MiguelCama/AVR-VemaQ-Controller/PCB_Layout.png

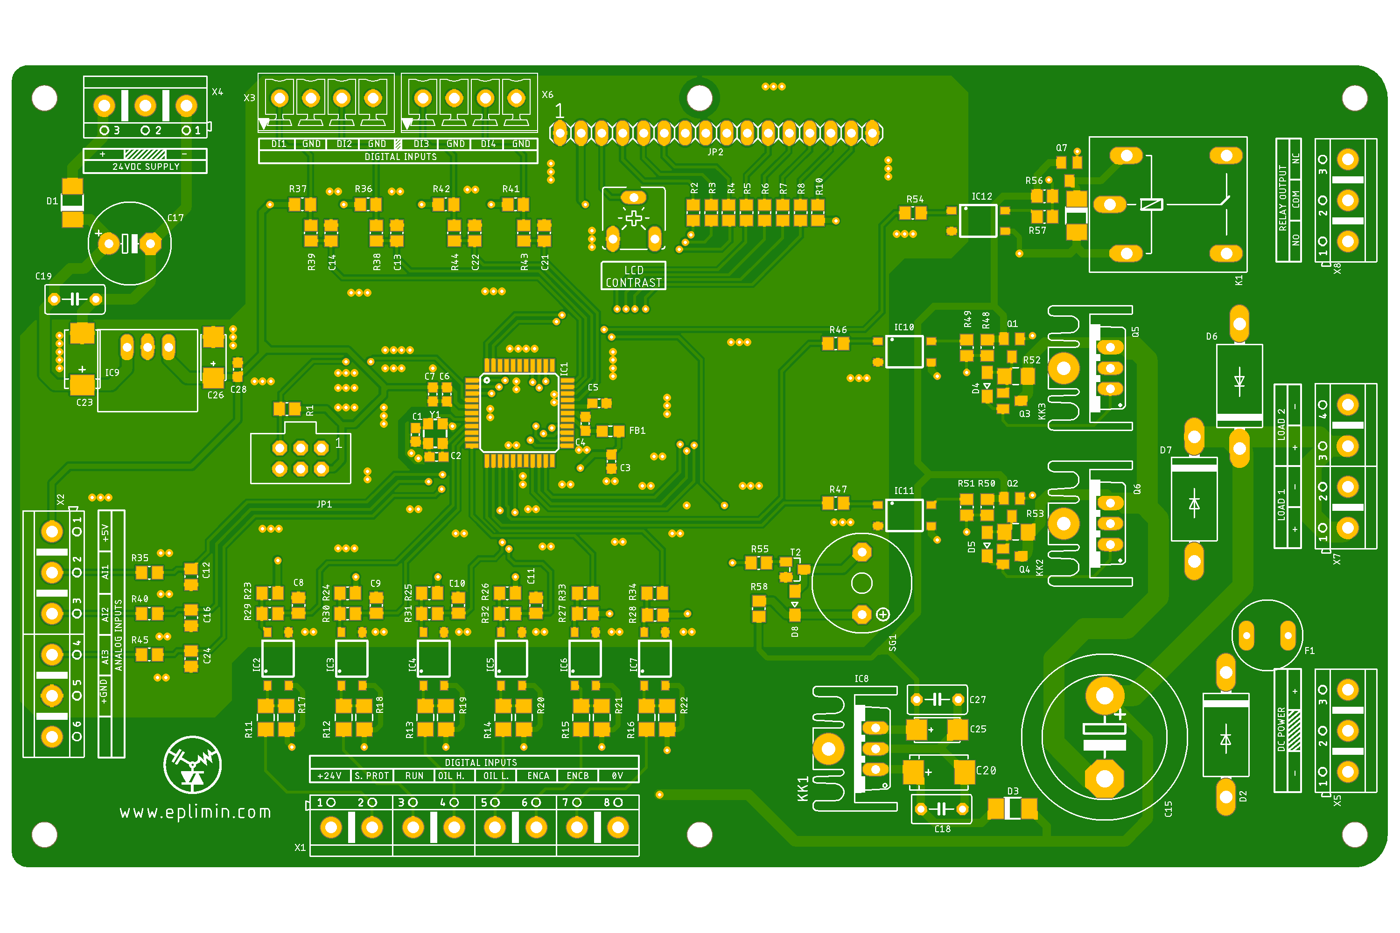
PCB_Layout.png
