MiguelCama/AVR-VemaQ-Controller/Requirements.png

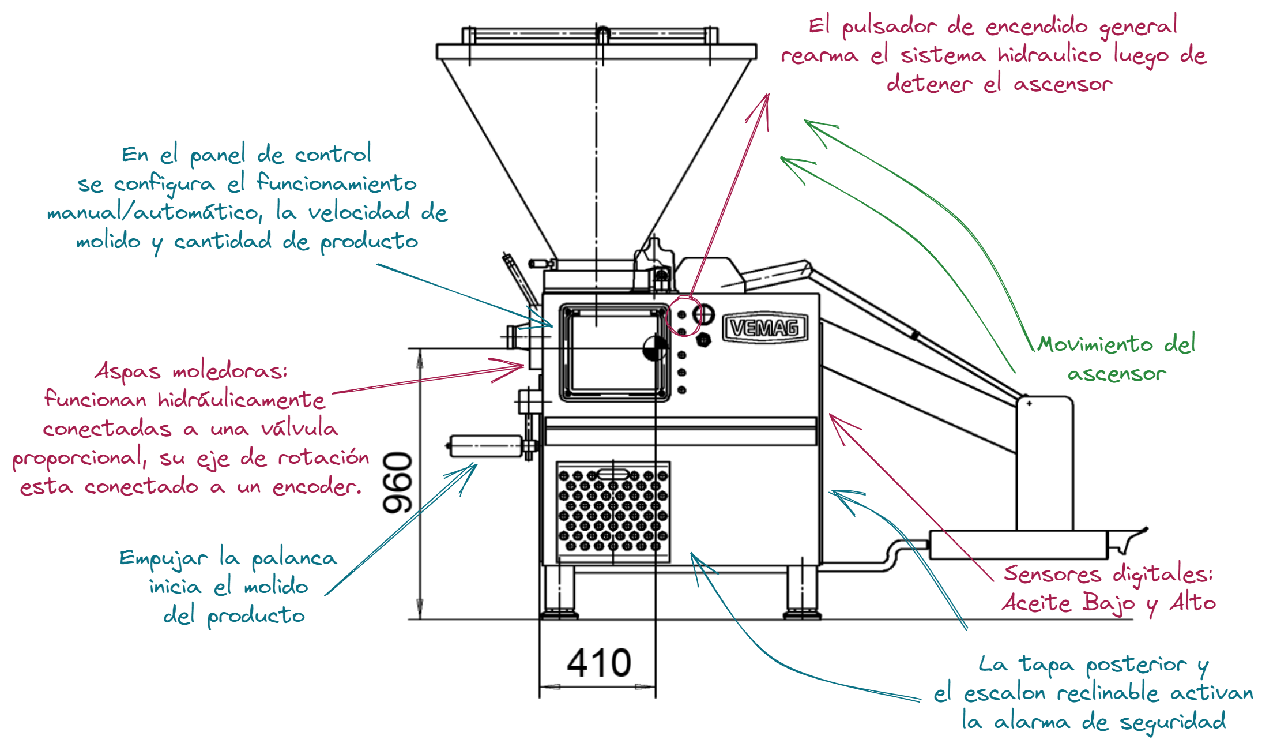
Requirements.png
