MiguelCama/AVR-VemaQ-Controller/FSM_UML.pdf

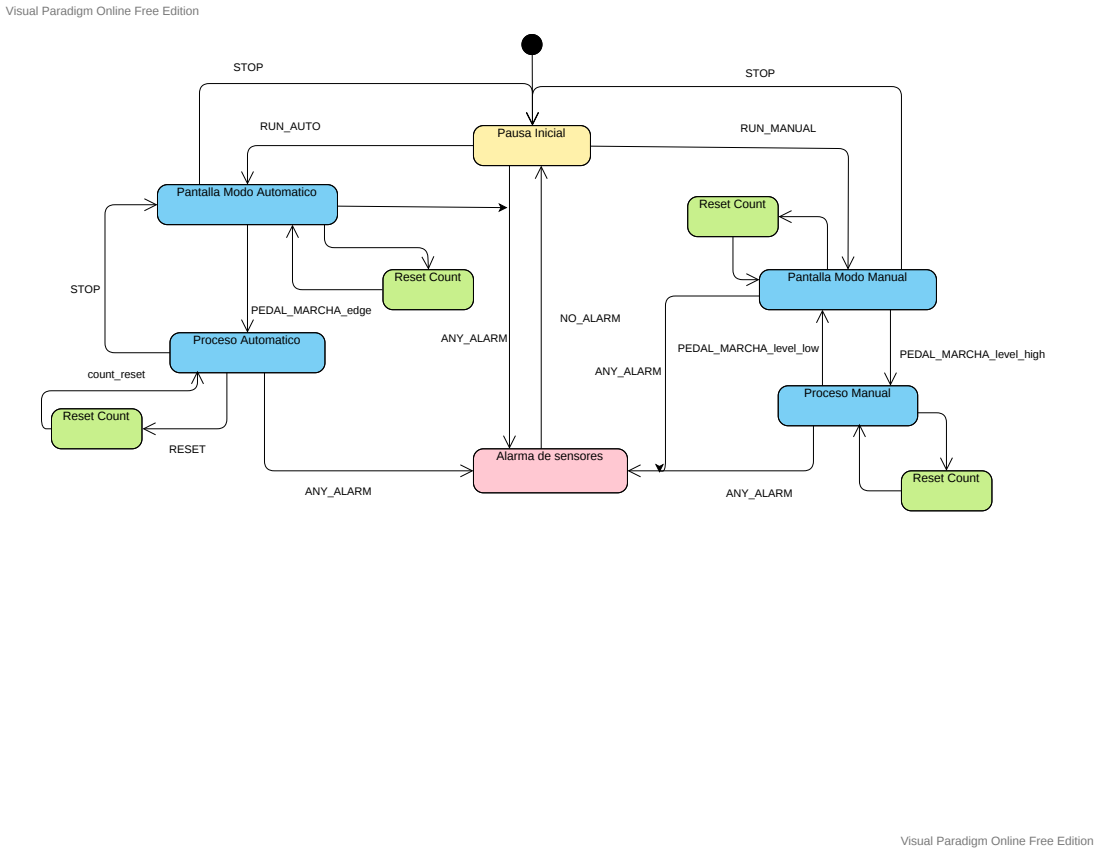
[picture p3: page 1]
Pausa Inicial; ANY_ALARM; RUN_MANUAL; RUN_AUTO; Proceso Automatico; Proceso Manual; PEDAL_MARCHA_edge; PEDAL_MARCHA_level_high; NO_ALARM; STOP; Reset Count; RESET; count_reset; PEDAL_MARCHA_level_low

Visual Paradigm Online Free Edition

Pantalla Modo Automatico

Pantalla Modo Manual

Alarma de sensores
