MiguelCama/AVR-VemaQ-Controller/Schematic/vemag_CPU_v2_2.brd

## EAGLE design Schematic/vemag_CPU_v2_2.brd (2024-03-04)

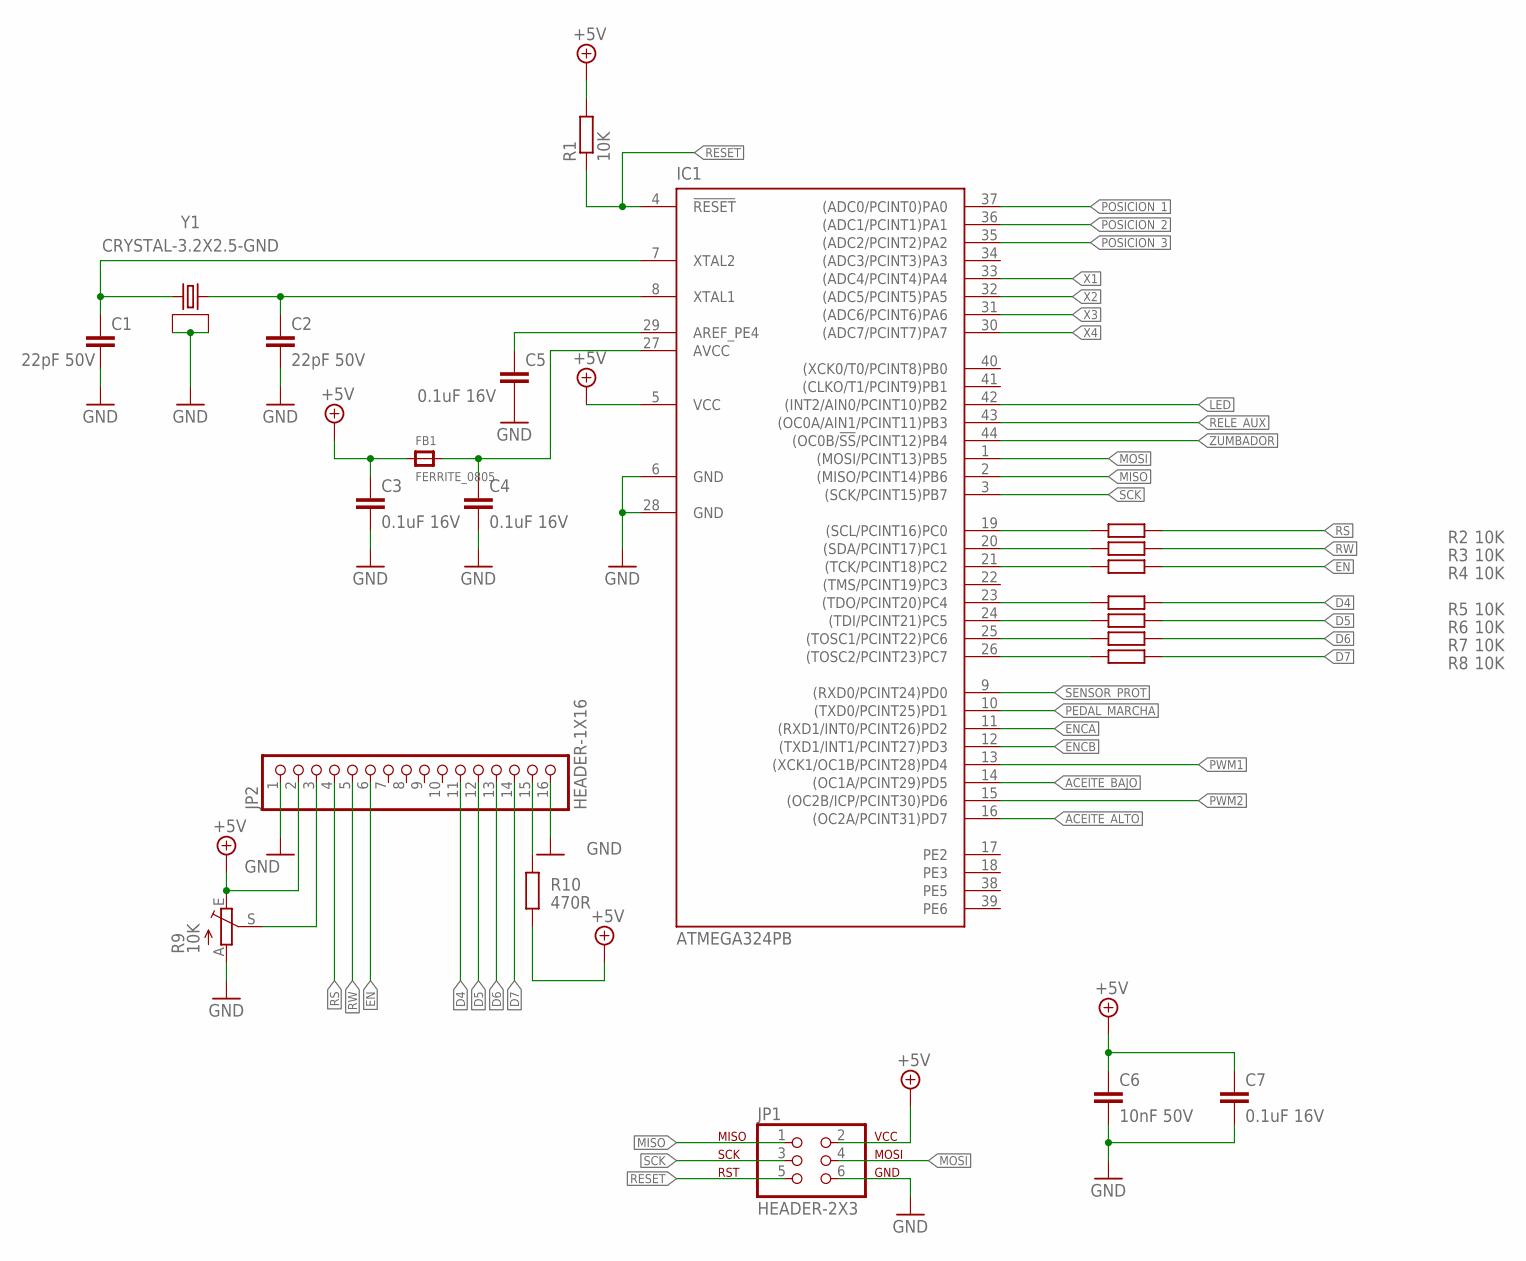
[picture p4: schematic vemag_CPU_v2_2.sch, sheet 1, Microcontroller]

Parts:
C1, C2: 22pF 50V; C0603
C3, C4, C5, C7: 0.1uF 16V; C0603
C6: 10nF 50V; C0603
FB1: FERRITE_0805; _0805
IC1: ATMEGA324PB; TQFP44
JP1: HEADER-2X3; ISP_AVR_6P
JP2: HEADER-1X16; 1X16
R1, R2, R3, R4, R5, R6, R7, R8: 10K; R0805
R9: 10K; CA6V
R10: 470R; R0805
Y1: CRYSTAL-3.2X2.5-GND; CRYSTAL-SMD-3.2X2.5MM

Connections:
+5V: C3.1, C6.1, C7.1, FB1.1, IC1.5 (VCC), JP1.2, JP2.2, R1.2, R9.E, R10.1; also elsewhere on the board
ACEITE_ALTO: IC1.16 ((OC2A/PCINT31)PD7); also elsewhere on the board
ACEITE_BAJO: IC1.14 ((OC1A/PCINT29)PD5); also elsewhere on the board
D4: JP2.11, R5.1
D5: JP2.12, R6.1
D6: JP2.13, R7.1
D7: JP2.14, R8.1
EN: JP2.6, R4.1
ENCA: IC1.11 ((RXD1/INT0/PCINT26)PD2); also elsewhere on the board
ENCB: IC1.12 ((TXD1/INT1/PCINT27)PD3); also elsewhere on the board
GND: C1.2, C2.2, C3.2, C4.2, C5.2, C6.2, C7.2, IC1.6 (GND), IC1.28 (GND), JP1.6, JP2.1, JP2.16, R9.A, Y1.2 (GND), Y1.4 (GND); also elsewhere on the board
LED: IC1.42 ((INT2/AIN0/PCINT10)PB2)
MISO: IC1.2 ((MISO/PCINT14)PB6), JP1.1
MOSI: IC1.1 ((MOSI/PCINT13)PB5), JP1.4
unnamed: C1.1, IC1.7 (XTAL2), Y1.1 (2)
unnamed: C2.1, IC1.8 (XTAL1), Y1.3 (1)
unnamed: C5.1, IC1.29 (AREF_PE4)
unnamed: JP2.3, R9.S
unnamed: C4.1, FB1.2, IC1.27 (AVCC)
unnamed: IC1.26 ((TOSC2/PCINT23)PC7), R8.2
unnamed: IC1.25 ((TOSC1/PCINT22)PC6), R7.2
unnamed: IC1.24 ((TDI/PCINT21)PC5), R6.2
unnamed: IC1.23 ((TDO/PCINT20)PC4), R5.2
unnamed: IC1.21 ((TCK/PCINT18)PC2), R4.2
unnamed: IC1.20 ((SDA/PCINT17)PC1), R3.2
unnamed: IC1.19 ((SCL/PCINT16)PC0), R2.2
unnamed: JP2.15, R10.2
PE2: IC1.17 (PE2)
PE3: IC1.18 (PE3)
PE5: IC1.38 (PE5)
PE6: IC1.39 (PE6)
PEDAL_MARCHA: IC1.10 ((TXD0/PCINT25)PD1); also elsewhere on the board
POSICION_1: IC1.37 ((ADC0/PCINT0)PA0); also elsewhere on the board
POSICION_2: IC1.36 ((ADC1/PCINT1)PA1); also elsewhere on the board
POSICION_3: IC1.35 ((ADC2/PCINT2)PA2); also elsewhere on the board
PWM1: IC1.13 ((XCK1/OC1B/PCINT28)PD4); also elsewhere on the board
PWM2: IC1.15 ((OC2B/ICP/PCINT30)PD6); also elsewhere on the board
RELE_AUX: IC1.43 ((OC0A/AIN1/PCINT11)PB3); also elsewhere on the board
RESET: IC1.4 (!RESET), JP1.5, R1.1
RS: JP2.4, R2.1
RW: JP2.5, R3.1
SCK: IC1.3 ((SCK/PCINT15)PB7), JP1.3
SENSOR_PROT: IC1.9 ((RXD0/PCINT24)PD0); also elsewhere on the board
X1: IC1.33 ((ADC4/PCINT4)PA4); also elsewhere on the board
X2: IC1.32 ((ADC5/PCINT5)PA5); also elsewhere on the board
X3: IC1.31 ((ADC6/PCINT6)PA6); also elsewhere on the board
X4: IC1.30 ((ADC7/PCINT7)PA7); also elsewhere on the board
ZUMBADOR: IC1.44 ((OC0B/!SS!/PCINT12)PB4); also elsewhere on the board

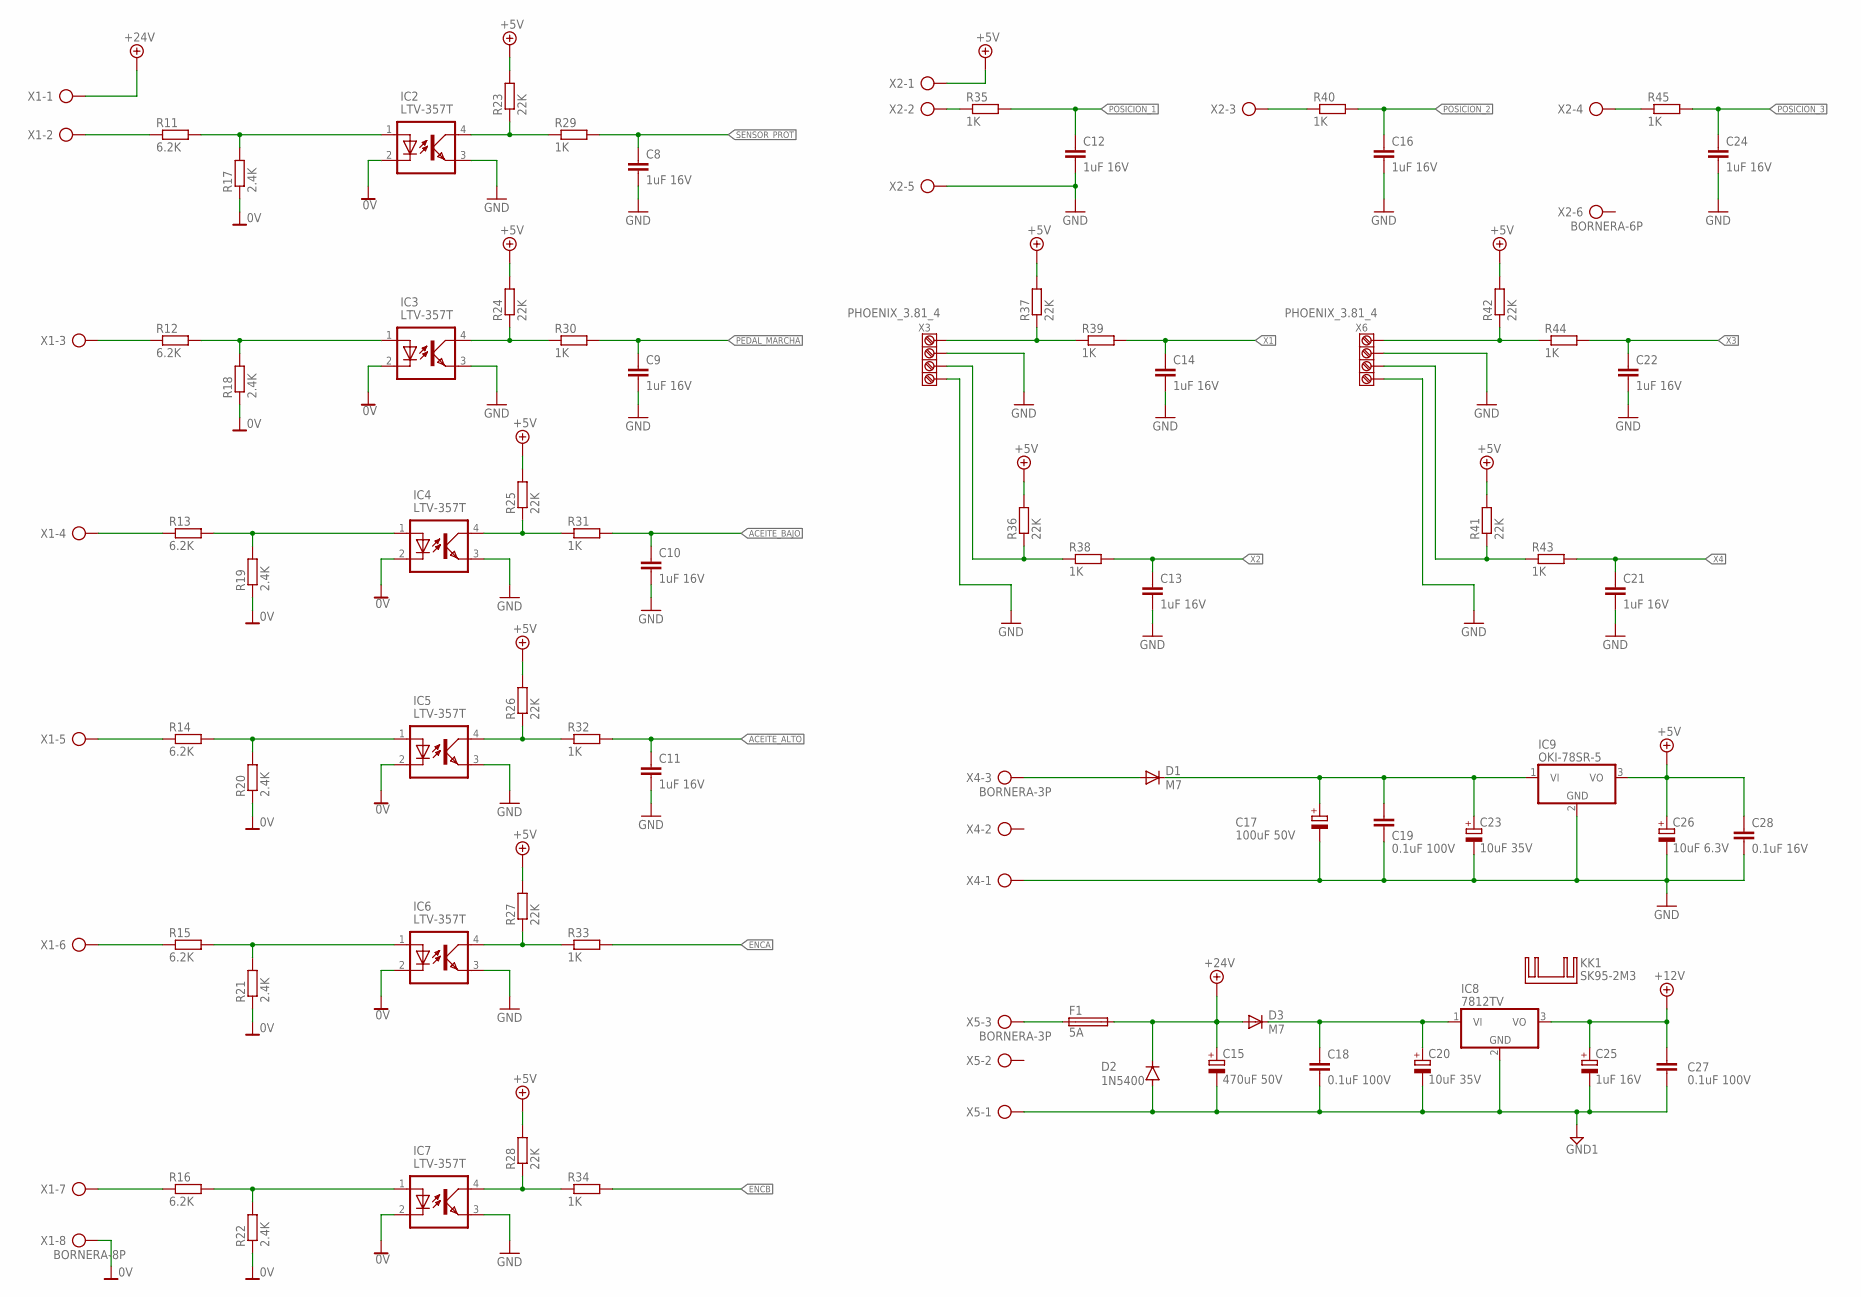
[picture p5: schematic vemag_CPU_v2_2.sch, sheet 2, Inputs / Power Supply]

Parts:
C8, C9, C10, C11, C12, C13, C14, C16, C21, C22, C24: 1uF 16V; C0805
C15: 470uF 50V; EB20D
C17: 100uF 50V; E5-10,5
C18, C19, C27: 0.1uF 100V; C050-035X075
C20, C23: 10uF 35V; SMC_D
C25: 1uF 16V; SMC_C
C26: 10uF 6.3V; SMC_C
C28: 0.1uF 16V; C0603
D1, D3: M7; DIODE_DO-214AC
D2: 1N5400; DO201-15
F1: 5A; TR5
IC2, IC3, IC4, IC5, IC6, IC7: LTV-357T
IC8: 7812TV; TO220V
IC9: OKI-78SR-5; TO220V-OKI-ISO
KK1: SK95-2M3
R11, R12, R13, R14, R15, R16: 6.2K; R1206
R17, R18, R19, R20, R21, R22: 2.4K; R1206
R23, R24, R25, R26, R27, R28, R36, R37, R41, R42: 22K; R0805
R29, R30, R31, R32, R33, R34, R35, R38, R39, R40, R43, R44, R45: 1K; R0805
X1: BORNERA-8P; AK500/8
X2: BORNERA-6P; AK500/6
X3, X6: PHOENIX_3.81_4; 3.81-4
X4, X5: BORNERA-3P; AK500/3

Connections:
0V: IC2.2 (CATHODE), IC3.2 (CATHODE), IC4.2 (CATHODE), IC5.2 (CATHODE), IC6.2 (CATHODE), IC7.2 (CATHODE), R17.1, R18.1, R19.1, R20.1, R21.1, R22.1, X1.8
+5V: C26.+, C28.1, IC9.3 (VO), R23.2, R24.2, R25.2, R26.2, R27.2, R28.2, R36.2, R37.2, R41.2, R42.2, X2.1; also elsewhere on the board
+12V: C25.+, C27.1, IC8.3 (VO); also elsewhere on the board
+24V: C15.+, D2.C, D3.A, F1.2, X1.1; also elsewhere on the board
ACEITE_ALTO: C11.1, R32.2; also elsewhere on the board
ACEITE_BAJO: C10.1, R31.2; also elsewhere on the board
ENCA: R33.2; also elsewhere on the board
ENCB: R34.2; also elsewhere on the board
GND: C8.2, C9.2, C10.2, C11.2, C12.2, C13.2, C14.2, C16.2, C17.-, C19.2, C21.2, C22.2, C23.-, C24.2, C26.-, C28.2, IC2.3 (EM), IC3.3 (EM), IC4.3 (EM), IC5.3 (EM), IC6.3 (EM), IC7.3 (EM), IC9.2 (GND), X2.5, X3.2, X3.4, X4.1, X6.2, X6.4; also elsewhere on the board
GND1: C15.-, C18.2, C20.-, C25.-, C27.2, D2.A, IC8.2 (GND), X5.1; also elsewhere on the board
unnamed: D1.A, X4.3
unnamed: IC2.1 (ANODE), R11.2, R17.2
unnamed: IC2.4 (COL), R23.1, R29.1
unnamed: R35.1, X2.2
unnamed: IC3.1 (ANODE), R12.2, R18.2
unnamed: C18.1, C20.+, D3.C, IC8.1 (VI)
unnamed: IC3.4 (COL), R24.1, R30.1
unnamed: IC4.1 (ANODE), R13.2, R19.2
unnamed: IC4.4 (COL), R25.1, R31.1
unnamed: IC5.1 (ANODE), R14.2, R20.2
unnamed: IC5.4 (COL), R26.1, R32.1
unnamed: IC6.1 (ANODE), R15.2, R21.2
unnamed: IC6.4 (COL), R27.1, R33.1
unnamed: IC7.1 (ANODE), R16.2, R22.2
unnamed: IC7.4 (COL), R28.1, R34.1
unnamed: R16.1, X1.7
unnamed: R15.1, X1.6
unnamed: R14.1, X1.5
unnamed: R13.1, X1.4
unnamed: R12.1, X1.3
unnamed: R11.1, X1.2
unnamed: F1.1, X5.3
unnamed: C17.+, C19.1, C23.+, D1.C, IC9.1 (VI)
unnamed: R40.1, X2.3
unnamed: R45.1, X2.4
unnamed: R37.1, R39.1, X3.1
unnamed: R36.1, R38.1, X3.3
unnamed: R42.1, R44.1, X6.1
unnamed: R41.1, R43.1, X6.3
PEDAL_MARCHA: C9.1, R30.2; also elsewhere on the board
POSICION_1: C12.1, R35.2; also elsewhere on the board
POSICION_2: C16.1, R40.2; also elsewhere on the board
POSICION_3: C24.1, R45.2; also elsewhere on the board
SENSOR_PROT: C8.1, R29.2; also elsewhere on the board
X1: C14.1, R39.2; also elsewhere on the board
X2: C13.1, R38.2; also elsewhere on the board
X3: C22.1, R44.2; also elsewhere on the board
X4: C21.1, R43.2; also elsewhere on the board

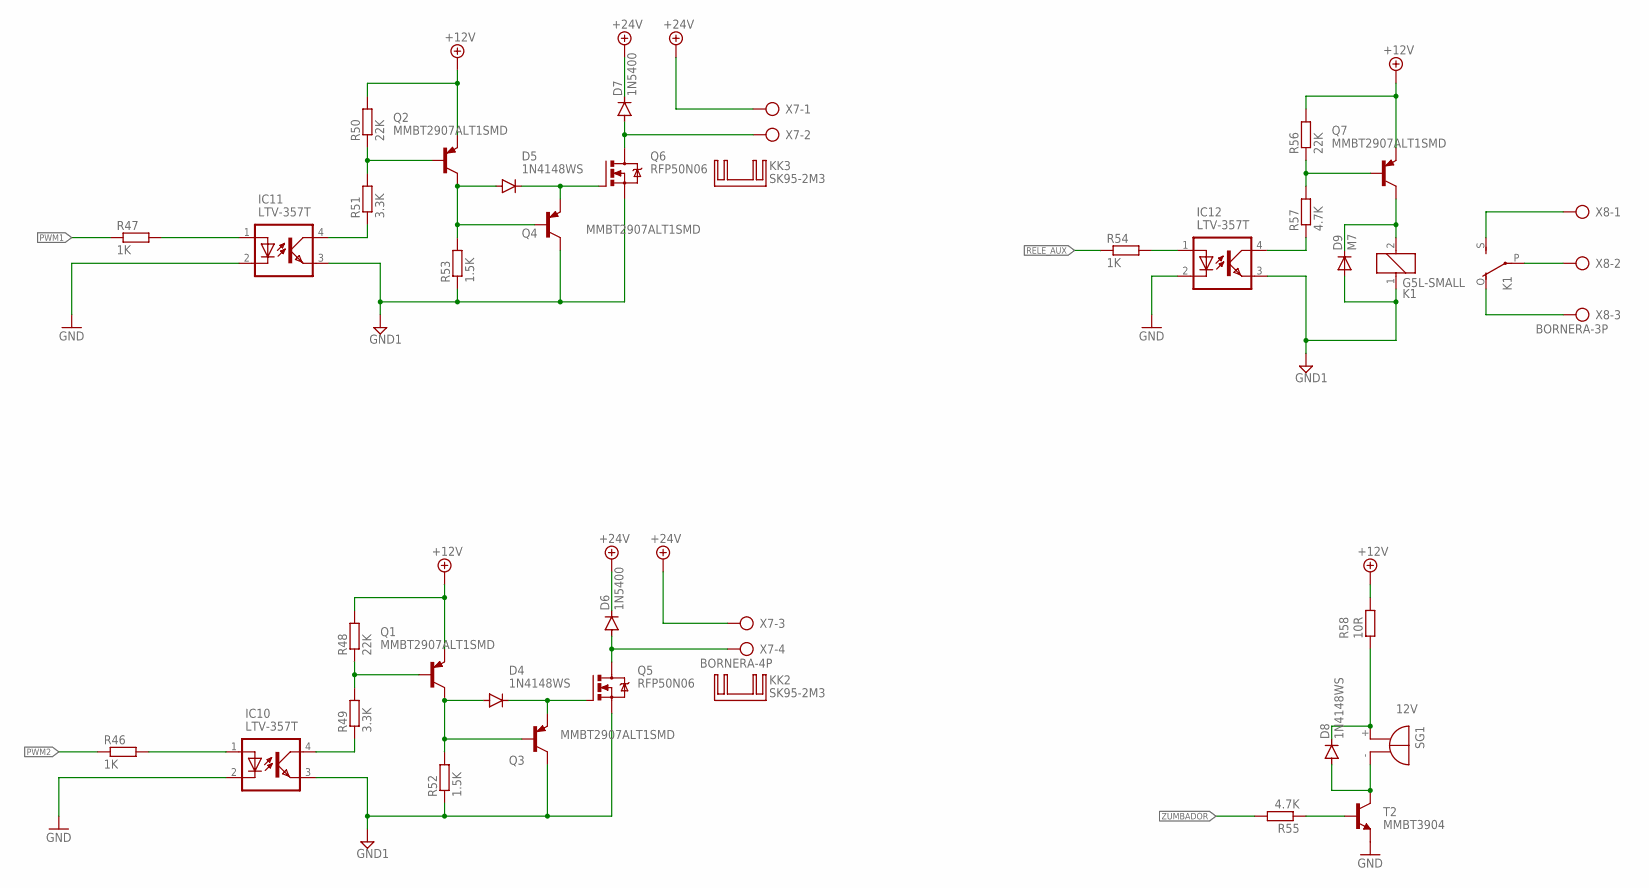
[picture p6: schematic vemag_CPU_v2_2.sch, sheet 3, Outputs]

Parts:
D4, D5, D8: 1N4148WS; DIODE_SOD323-W
D6, D7: 1N5400; DO201-15
D9: M7; DIODE_DO-214AC
IC10, IC11, IC12: LTV-357T
K1: G5L-SMALL; G5LE-SMALL
KK2, KK3: SK95-2M3
Q1, Q2, Q3, Q4, Q7: MMBT2907ALT1SMD; SOT23-BEC
Q5, Q6: RFP50N06; TO220BV
R46, R47, R54: 1K; R0805
R48, R50, R56: 22K; R0805
R49, R51: 3.3K; R0805
R52, R53: 1.5K; R1206
R55, R57: 4.7K; R0805
R58: 10R; R0805
SG1: 12V; F/TMB
T2: MMBT3904; SOT23-BEC
X7: BORNERA-4P; AK500/4
X8: BORNERA-3P; AK500/3

Connections:
+12V: Q1.E, Q2.E, Q7.E, R48.2, R50.2, R56.2, R58.1; also elsewhere on the board
+24V: D6.C, D7.C, X7.1, X7.3; also elsewhere on the board
GND: IC10.2 (CATHODE), IC11.2 (CATHODE), IC12.2 (CATHODE), T2.E; also elsewhere on the board
GND1: D9.A, IC10.3 (EM), IC11.3 (EM), IC12.3 (EM), K1.1, Q3.C, Q4.C, Q5.S, Q6.S, R52.1, R53.1; also elsewhere on the board
unnamed: IC11.1 (ANODE), R47.2
unnamed: D8.C, R58.2, SG1.+
unnamed: D5.A, Q2.C, Q4.B, R53.2
unnamed: IC11.4 (COL), R51.1
unnamed: Q2.B, R50.1, R51.2
unnamed: IC10.1 (ANODE), R46.2
unnamed: D5.C, Q4.E, Q6.G
unnamed: D7.A, Q6.D, X7.2
unnamed: K1.S, X8.1
unnamed: K1.P, X8.2
unnamed: IC10.4 (COL), R49.1
unnamed: Q1.B, R48.1, R49.2
unnamed: D4.A, Q1.C, Q3.B, R52.2
unnamed: D4.C, Q3.E, Q5.G
unnamed: D6.A, Q5.D, X7.4
unnamed: IC12.1 (ANODE), R54.2
unnamed: IC12.4 (COL), R57.1
unnamed: Q7.B, R56.1, R57.2
unnamed: D9.C, K1.2, Q7.C
unnamed: K1.O, X8.3
unnamed: R55.1, T2.B
unnamed: D8.A, SG1.-, T2.C
PWM1: R47.1; also elsewhere on the board
PWM2: R46.1; also elsewhere on the board
RELE_AUX: R54.1; also elsewhere on the board
ZUMBADOR: R55.2; also elsewhere on the board

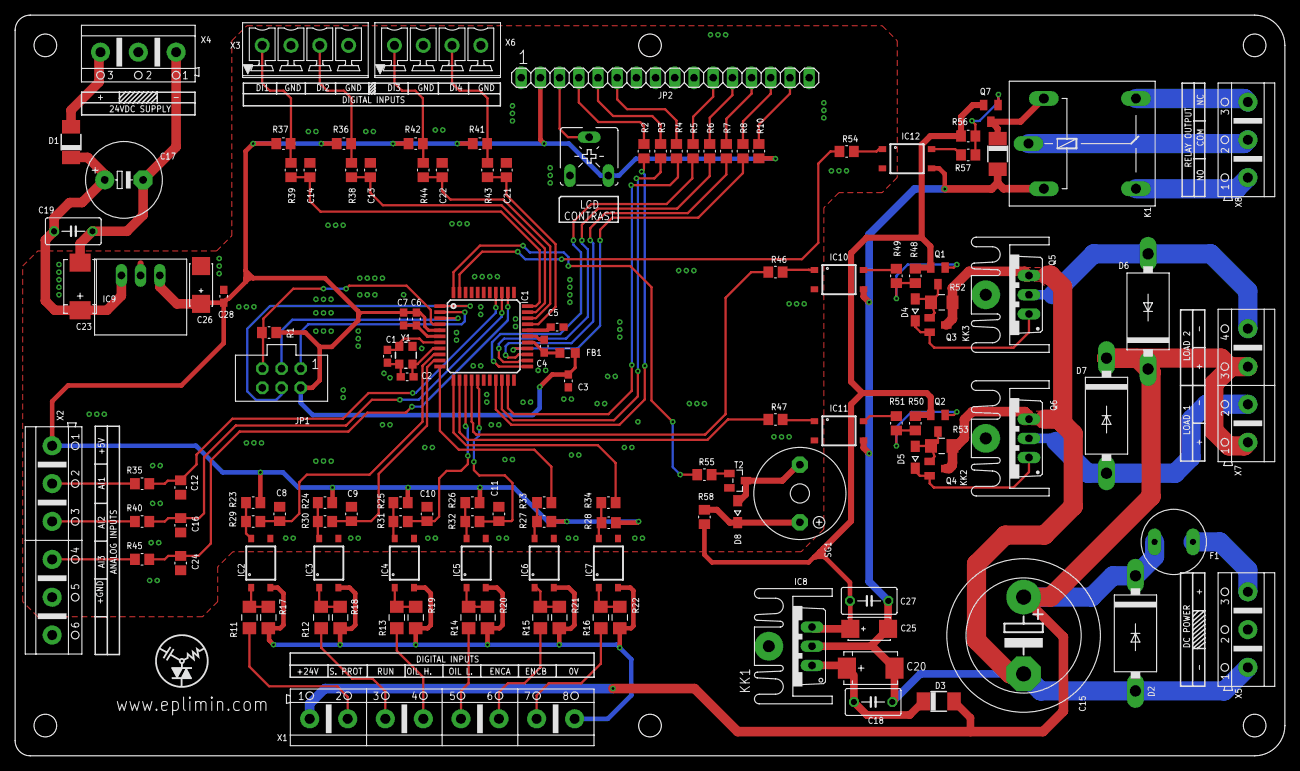
[picture p7: board vemag_CPU_v2_2.brd from above]

Board: 2 copper layers, 168.0 x 98.0 mm, 133 parts (0 on the bottom side), 98 nets.
