MiguelCama/AVR-VemaQ-Controller/Firmware/Proyect_Defines.h

/*
 * Proyect_Defines.h
 *
 * Created: 18/08/2022 12:39:25
 *  Author: Eplimin.sac
 */ 

#define F_CPU 16000000UL

#include <avr/io.h>
#include <stdint.h>
#include <stdbool.h>
#include <util/delay.h>
#include <avr/interrupt.h>



#include "Driver_ADC.h"
#include "Driver_GPIO.h"
#include "Driver_PWM.h"
#include "Driver_Encoder.h"
#include "HD44780.h"
#include "State_Machine.h"


#ifndef PROYECT_DEFINES_H_
#define PROYECT_DEFINES_H_



#endif /* PROYECT_DEFINES_H_ */
